PlanRobotShenZhen/SmartFOC-for-servo-motor/DOC/PLAN-SM60400D-BOM_20241017_V2.xls

Sheet: PLAN-SM60400D BOM清单
PLAN-SM60400D
序号 | 机械分类 | 层级 |  | 物料名称 | 物料编码 | 描述/规格型号 | 图示 | 材质 | 表面处理 | 数量 | 单位 | 物料类别 | 价格 | 总价 | 采购链接 | 备注 | 联系人 | 备注2
1 | 成品 | 1 |  | IPLAN-SM60400D | / | 成品，一体化伺服电机，IPLAN-SM60400D，Φ60*133.7 |  | / | / | 1 | 件 | 成品 | 63.99 |  |  |  |  | 20241017V2.0
2 |  |  | 2 | 400W电机主体 | / | 电机类，一体化伺服电机，400W，深圳丹青 |  | / | / | 1 | 件 | 半成品 | 0 |  |  |  | 深圳丹青 秦总
3 |  |  | 2 | 导光柱 | / | 机械其他，其他，导光柱，LDT3.0-2.5 |  | / | / | 1 | 件 | 半成品 | 0.21 |  | https://item.taobao.com/item.htm?_u=l20fbr48daa252&id=743519807618&skuId=5299771639683
4 |  |  | 2 | 400W后罩盖 | / | 机加件，一体化伺服电机，IPLAN-SM6040D，杭州雪尔 |  | 压铸铝 | / | 1 | 件 | 半成品 | 0 |  |  | / | 杭州雪尔 | 有18个样品，需寄出到杨金燕处二次加工
5 |  |  | 2 | 60驱动板 | / | PCBA,一体化伺服电机，60驱动板，带电源线和输出口 |  | / | / | 2 | 件 | / | 0 |  |  | 自制
6 |  |  | 2 | 导热硅胶片 | / | 机械其它，其它，60导热硅胶片，400mmx200mmx1.0mm，蓝色 |  | T=1， | / | 1 | 件 | / | 12 |  | https://item.taobao.com/item.htm?_u=h20fbr48dad315&id=642766611041&skuId=4896768733055 | 买一大片回来割 | 13825559441 | 买一块400x200x1.0mm厚
7 |  |  | 2 | 导热铝板 | / | 机械其他，其他，500mmx500mmx2.0mm，1060型材板 |  | 铝型材，T=2.0 | / | 1 | 件 | / | 50 |  | https://item.taobao.com/item.htm?id=750950364979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 | 50 |  | 买一件，直接发给杨金燕处加工
8 |  |  | 2 | 压线板 | / | 塑胶件，其他，压线板， |  | 12.9级 | / | 1 | 个 | / | 1 |  |  | 步进电机压线板，购买现成。左侧压板带硅胶垫0.81套；右侧一个压板0.5元/个 | 张总 13806120727 | 各买20个，需要顺丰到付
9 |  |  | 2 | 内六角圆柱头 M3*30 | / | 机械其他，其他，内六角圆柱头， M3*30，12.9级 |  | 12.9级 | / | 4 | 个 | / | 0.5 |  | https://detail.tmall.com/item.htm?id=22060492907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 | 电机主体与后盖固定 |  | 买2包,共计100个
10 |  |  | 2 | 内六角圆柱头 M2.5*6 | / | 机械其他，其他，内六角圆柱头， M2.5*6，12.9级 |  | 12.9级 | / | 3 | 个 | / | 0.1 |  | https://detail.tmall.com/item.htm?id=22060492907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 | 驱动板与电机主体固定 |  | 买1包/100个
11 |  |  | 2 | 内六角圆柱头 M2.5*10 |  | 机械其他，其他，内六角圆柱头， M2.5*10，12.9级 |  | 12.9级 |  | 4 | 个 |  | 0.05 |  | https://detail.tmall.com/item.htm?id=22060492907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 | 压线板与后罩盖固定 |  | 买1包/100个
12 |  |  | 2 | M2.5x18铜螺柱 | / | 机械其他，其他，M2.5x18铜螺柱 |  |  | / | 3 | 个 | / | 0.13 |  | https://detail.tmall.com/item.htm?id=541776094503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 | 后盖与散热器固定 |  | 买12包

Sheet: PLAN-SM60400D BOM清单加散热片
PLAN-SM60400D
序号 | 机械分类 | 层级 |  | 物料名称 | 物料编码 | 描述/规格型号 | 图示 | 材质 | 表面处理 | 数量 | 单位 | 物料类别 | 子件属性 | 价格 | 采购链接 | 备注 | 联系人 | 价格
1 | 成品 | 1 |  | IPLAN-SM60400D | / | 成品，一体化伺服电机，IPLAN-SM60400D，Φ60*133.7 |  | / | / | 1 | 件 | 成品 | 自制 | 7.99
2 |  |  | 2 | 400W电机主体 | / | 电机类，一体化伺服电机，400W，深圳丹青 |  | / | / | 1 | 件 | 半成品 | 外购 | 0 |  |  | 深圳丹青 秦总
3 |  |  | 2 | 导光柱 | / | 机械其他，其他，导光柱，LDT3.0-2.5 |  | / | / | 1 | 件 | 半成品 | 外购 | 0.21 | https://m.tb.cn/h.gj1XdSfViKA3yo0?tk=0w4k3X6rAfo CZ8908
4 |  |  | 2 | 400W后罩盖 | / | 机加件，一体化伺服电机，IPLAN-SM6040D，杭州雪尔 |  | 压铸铝 | / | 1 | 件 | 半成品 |  | 0 |  | / | 杭州雪尔
5 |  |  | 2 | 60驱动板 | / | PCBA,一体化伺服电机，60驱动板，带电源线、输出口 |  | / | / | 2 | 件 | / |  | 0 |  | 自制
6 |  |  | 2 | 导热硅胶片 | / | 机械其它，其它，60导热硅胶片，蓝色 |  | T=1， | / | 2 | 件 | / |  | 0 |  | 买一大片回来割 | 13825559441
7 |  |  | 2 | 导热铝板 | / | 机械其他，其他，1060型材板 |  | 铝型材，T=2.5 | / | 1 | 件 | / |  | 0 | https://m.tb.cn/h.gkkbv0WhST8rvBm?tk=iwaQ3Wp0bP1 HU0025 | 打样100个200元
8 |  |  | 2 | 散热器 | / | 机械其他，其他，散热器，40x40x40mm |  | / | / | 1 | 件 | / |  | 6 | https://m.tb.cn/h.g8ySgl2Jiuj8HjG?tk=jsmI3coeYln MF1643 | 购买后，老杨处帮忙打孔
9 |  |  | 2 | 压线板 | / | 塑胶件，其他，压线板， |  | 12.9级 | / | 1 | 个 | / |  | 1 |  | 步进电机压线板 | 张总 13806120727
10 |  |  | 2 | 60伺服后罩密封垫 | / | 硅胶件，其他，60伺服后罩密封垫 |  | 硅胶 | / | 1 | 个 | / |  | 0 |  | 买一大片回来割；散热片与后罩盖之间
11 |  |  | 2 | 内六角圆柱头 M3*35 | / | 机械其他，其他，内六角圆柱头， M3*35，12.9级 |  | 12.9级 | / | 4 | 个 | / | 外购 | 0.5 |  | 电机主体与后盖固定
12 |  |  | 2 | 十字螺丝 M2.5*6 | / | 机械其他，其他，十字螺钉，M2.5*6，12.9级 |  | 12.9级 | / | 3 | 个 | / | 外购 | 0.1 |  | 驱动板与电机主体固定
13 |  |  | 2 | 内六角圆柱头 M2.5*10 |  | 机械其他，其他，内六角圆柱头， M2.5*10，12.9级 |  | 12.9级 |  | 4 | 个 |  | 外购 | 0.05 |  | 压线板与后罩盖固定
14 |  |  | 2 | 十字槽沉头螺钉 M3*6 | / | 机械其他，其他，十字槽沉头螺钉，M3*6，12.9级 |  | 12.9级 | / | 4 | 个 | / | 外购 | 0.13 |  | 后盖与散热器固定
