PlanRobotShenZhen/SmartFOC-for-servo-motor/DOC/PLANRobot_Servo_48V_V1_2_SCH.pdf

# DESCRIPTION

# VERSIONS RECORD

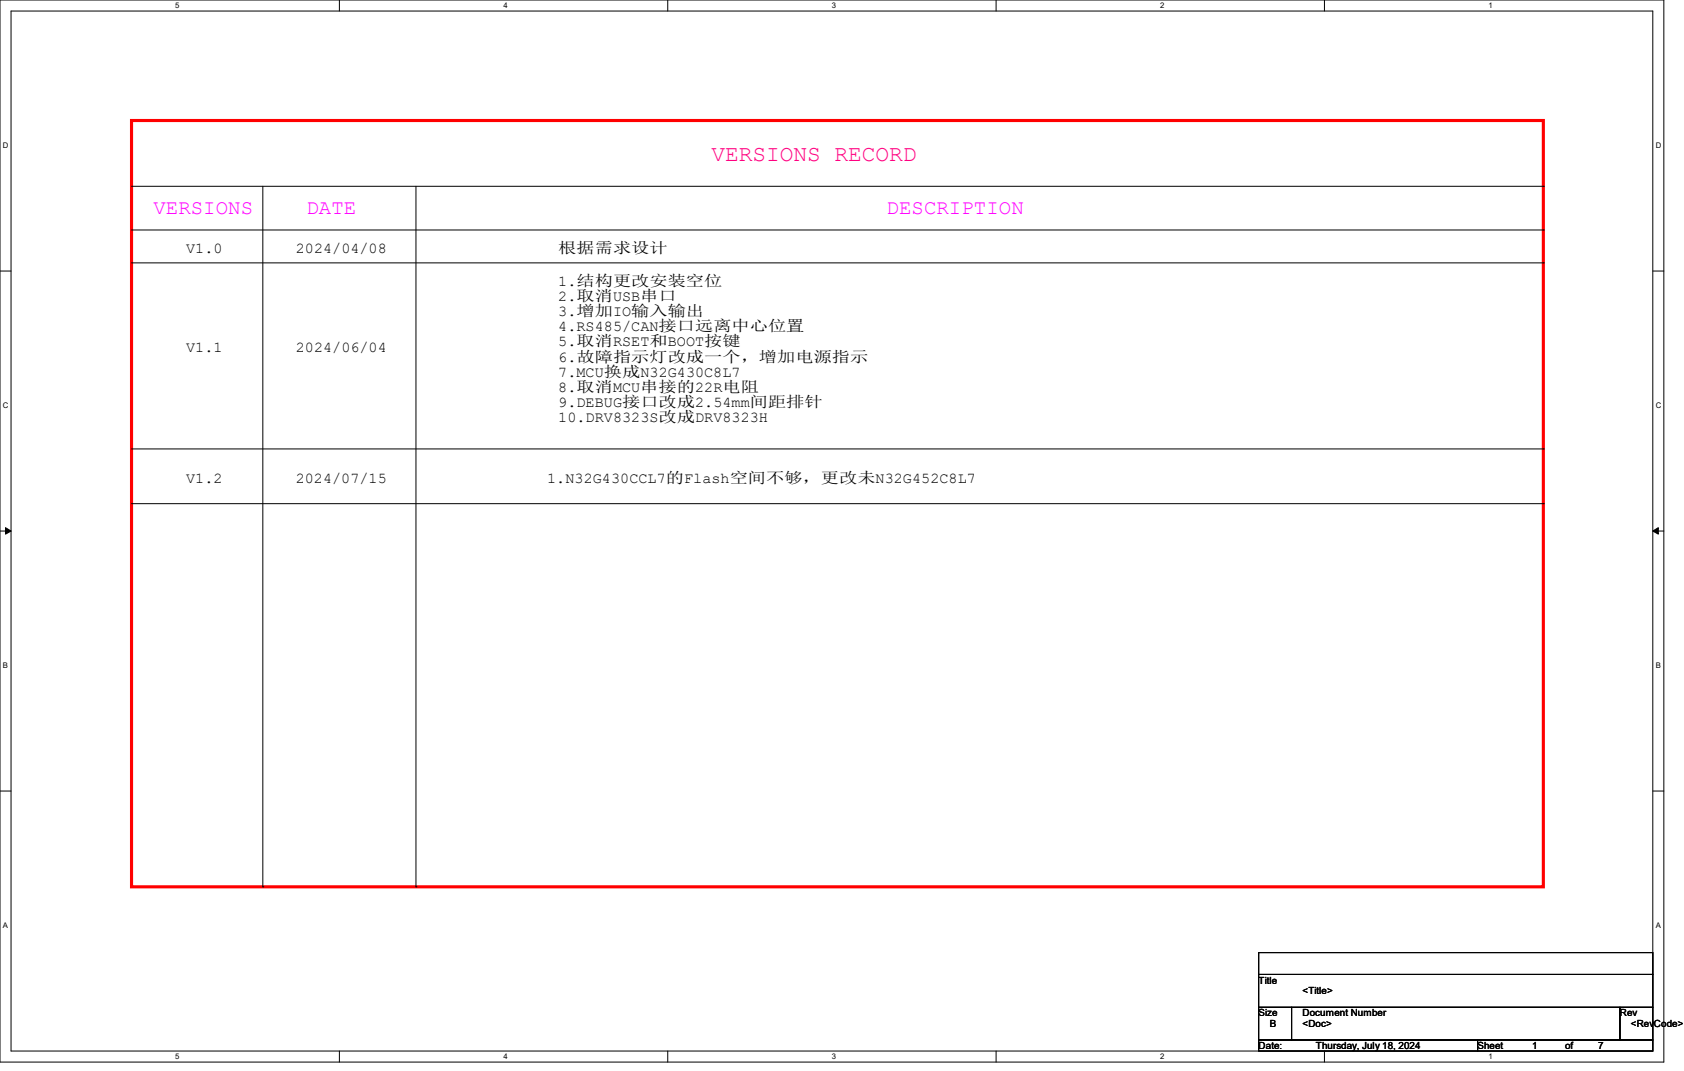
[picture p24: page 1]
VERSIONS; 根据需求设计; DATE; 1.结构更改安装空位 2.取消USB串口 3.增加IO输入输出 4.RS485/CAN接口远离中心位置 5.取消RSET和BOOT按键 6.故障指示灯改成一个，增加电源指示 7.MCU换成N32G430C8L7 8.取消MCU串接的22R电阻 9.DEBUG接口改成2.54mm间距排针 10.DRV8323S改成DRV8323H; 1.N32G430CCL7的Flash空间不够，更改未N32G452C8L7; Title Size; Document Number; Rev Date:; Sheet; of <Doc>; <RevCode>; <Title> B; Thursday, July 18, 2024; 7 Title Size

# BAT

(36-54.6V)

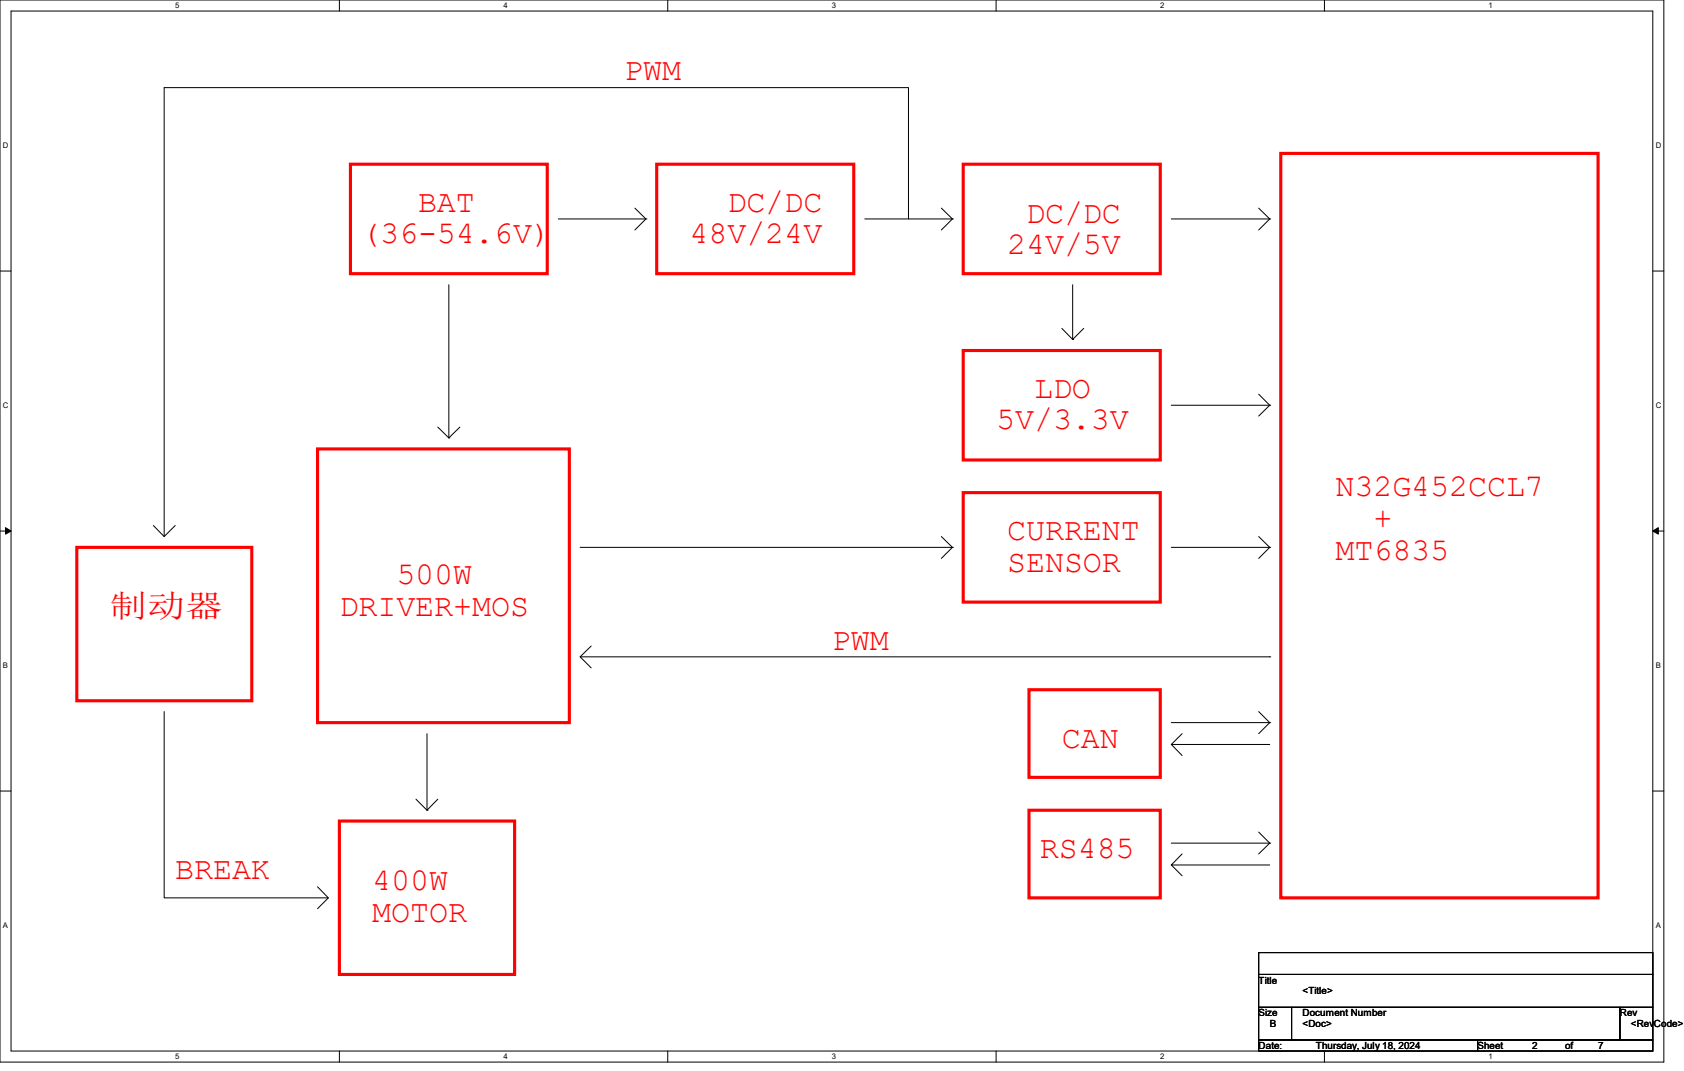
[picture p25: page 2]
LDO 5V/3.3V; N32G452CCL7 + MT6835; 500W DRIVER+MOS; 400W MOTOR; CURRENT SENSOR; PWM; BREAK; CAN; 制动器; Title Size; Document Number; Rev Date:; Sheet; of <Doc>; <RevCode>; <Title> B; Thursday, July 18, 2024; 7 Title Size

# DC/DC ->24V

## Rdown

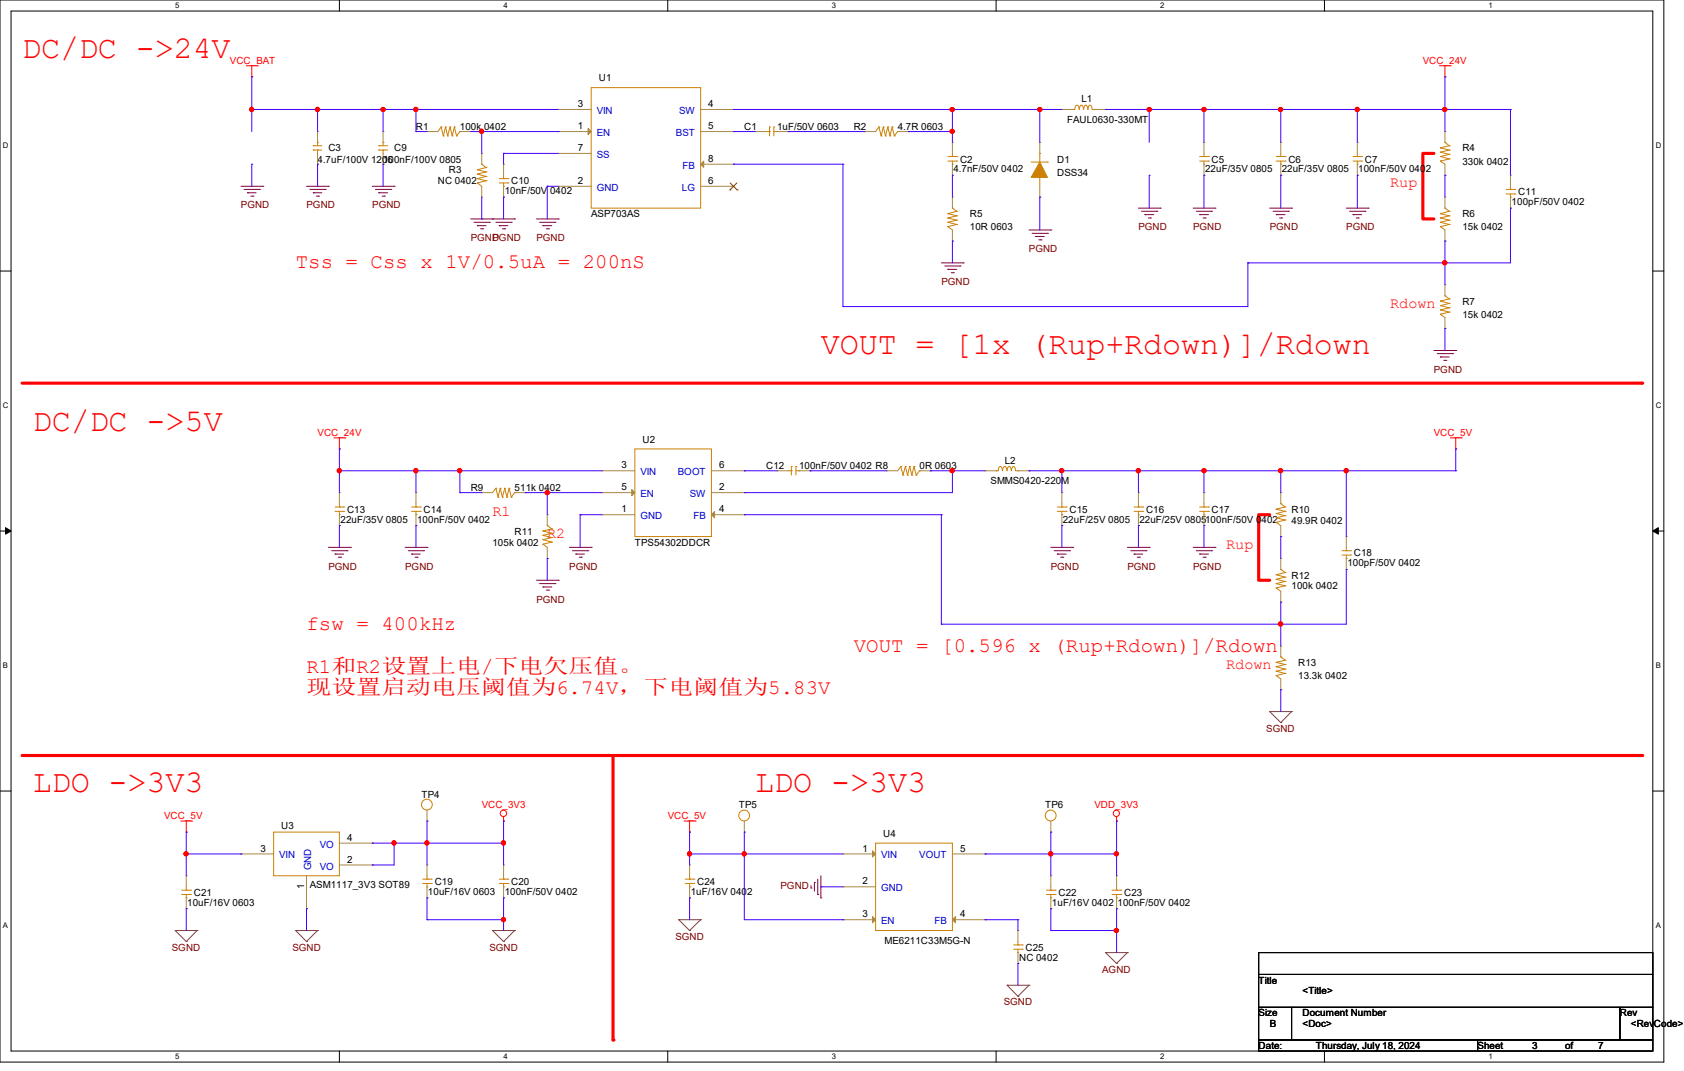
[picture p26: page 3]

VOUT = [1x (Rup+Rdown)]/Rdown

VOUT = [0.596 x (Rup+Rdown)]/Rdown

# 电机驱动

# 4.7nF/50V 0402 C38

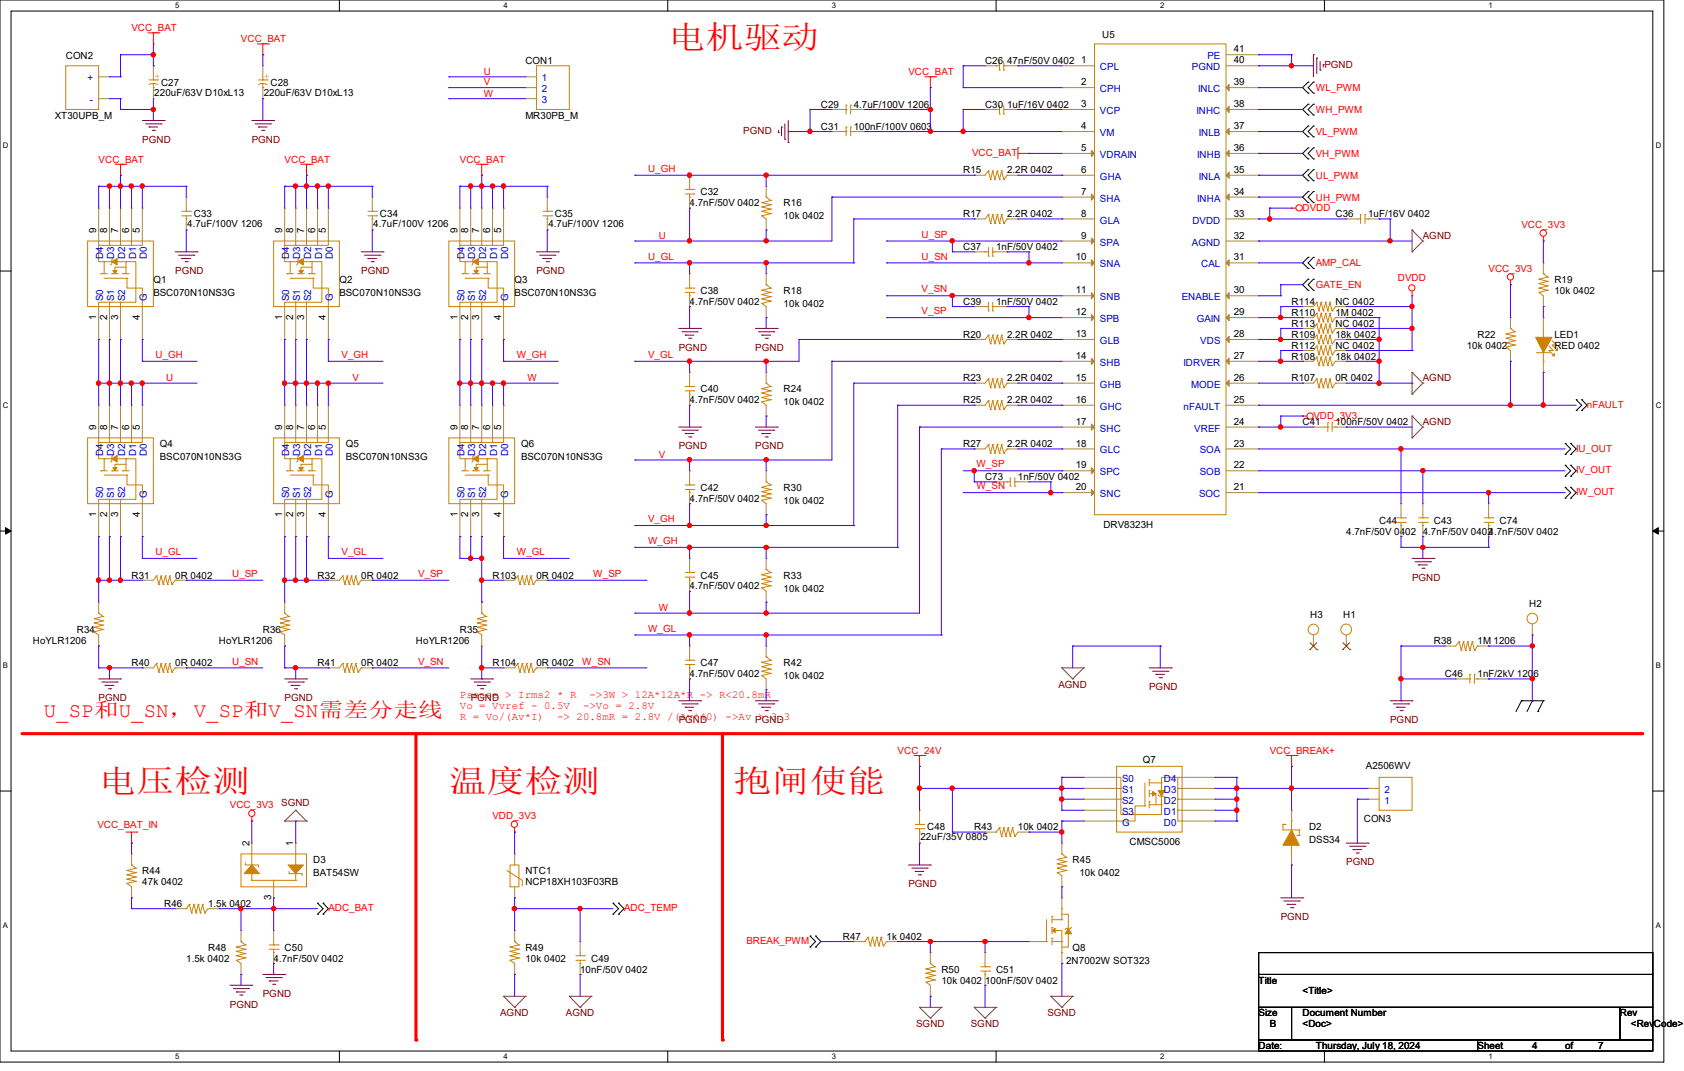
[picture p27: page 4]

R = Vo/(Av*I) -> 20.8mR = 2.8V /(Av*40) ->Av > 3.3 PGND

# DEBUG

# VCC_3V3 SGND

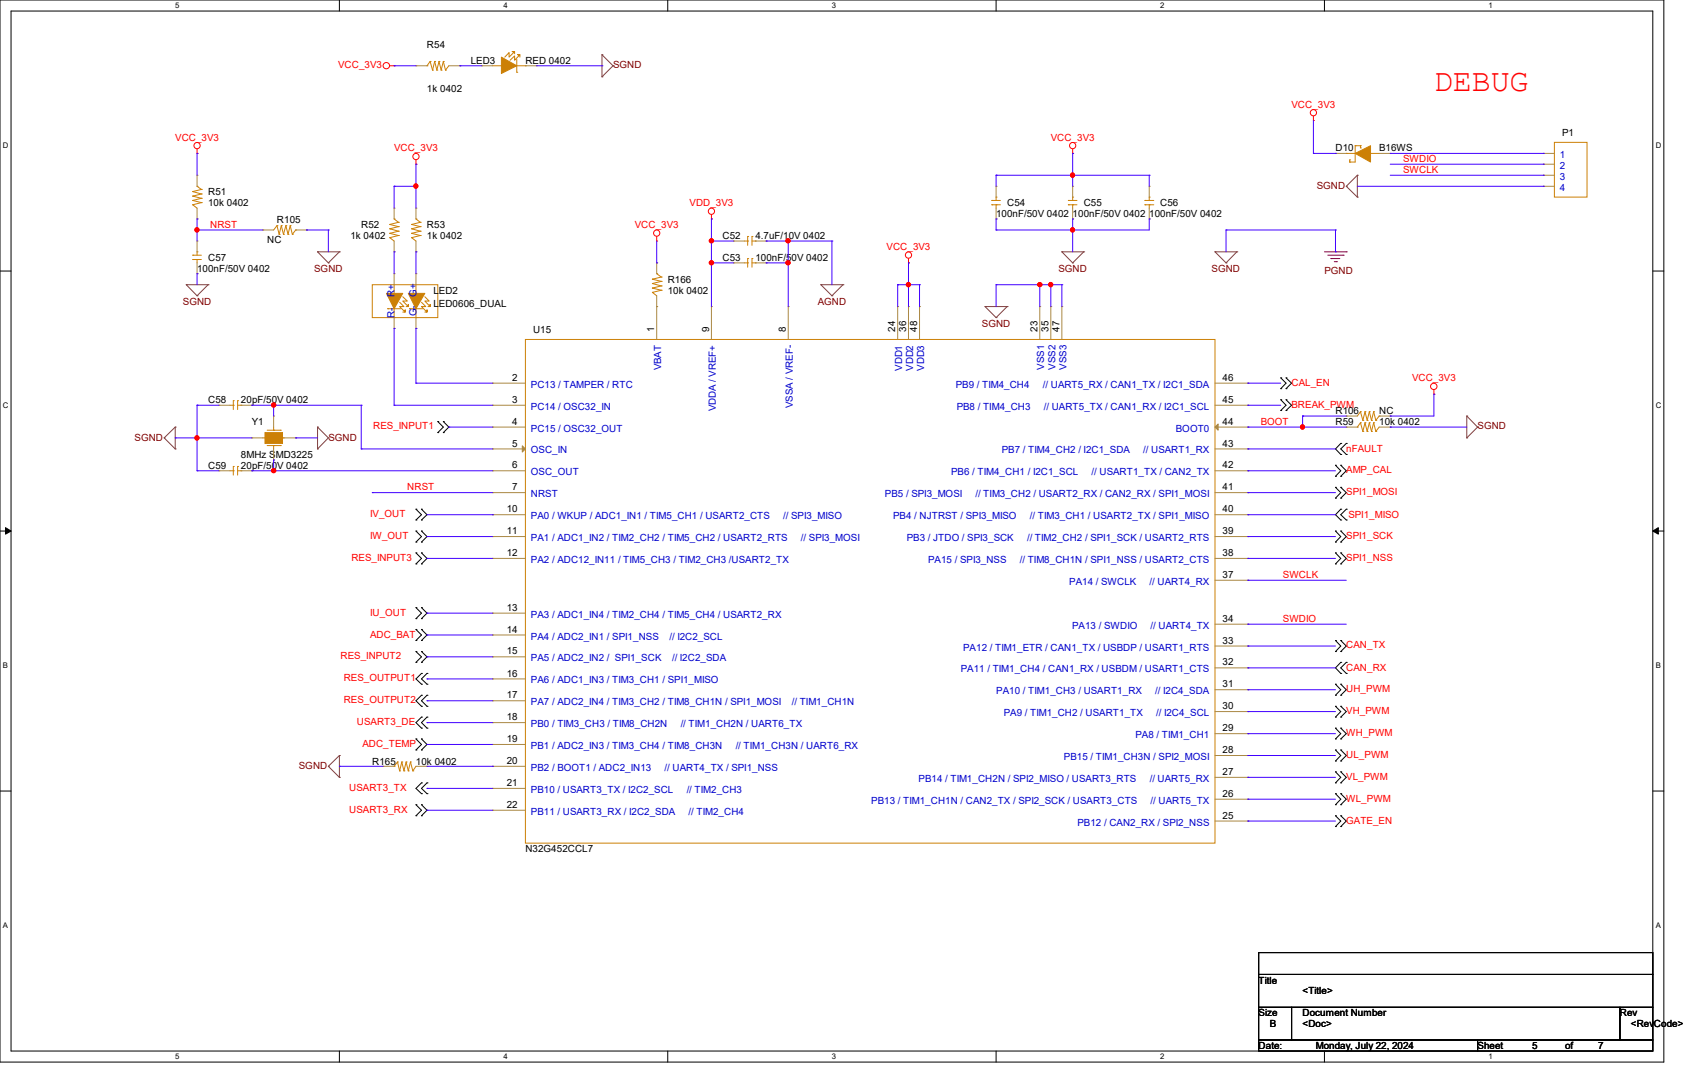
[picture p28: page 5]

# CAN通讯

# 6 A¹ A¹ A² A² D5 PESD1CAN

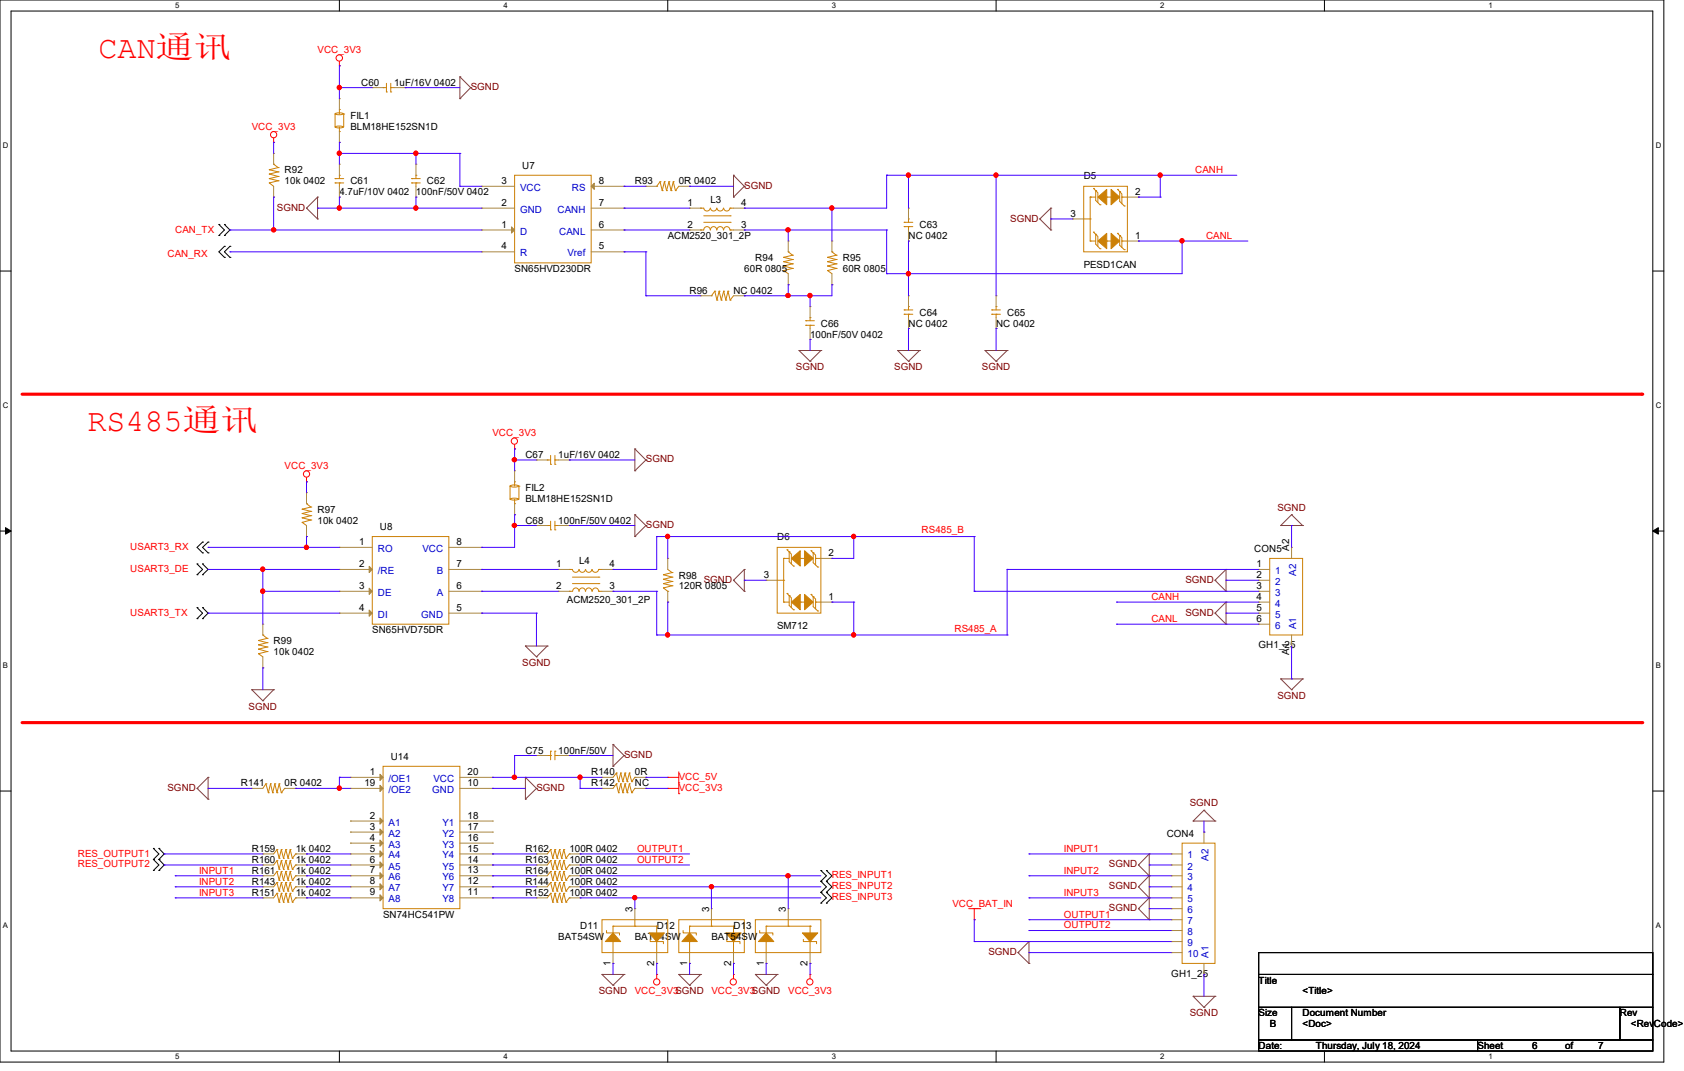
[picture p29: page 6]

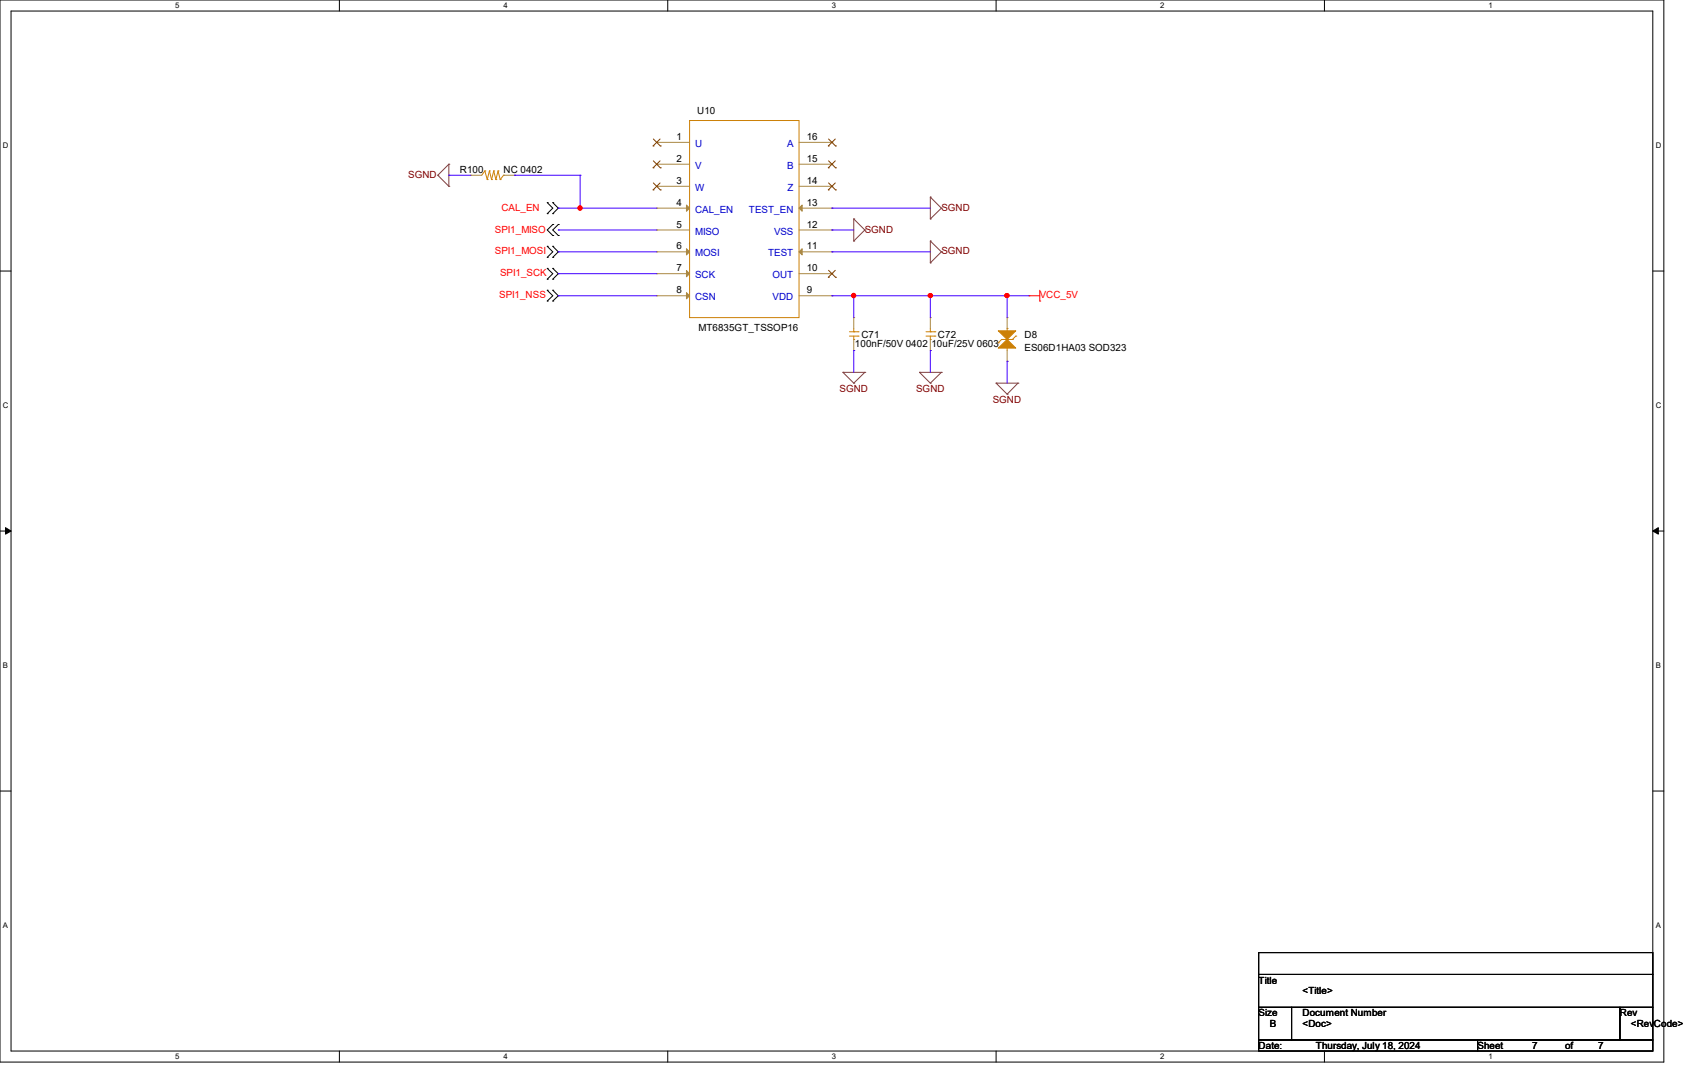
[picture p30: page 7]
VCC_5V; SGND; CAL_EN; SPI1_NSS; SPI1_SCK; SPI1_MOSI; SPI1_MISO; Title Size; Document Number; Rev Date:; Sheet; of <Doc>; <RevCode>; <Title> B; Thursday, July 18, 2024; 7 Title Size; U10 MT6835GT_TSSOP16 U; CAL_EN 4; MISO 5; MOSI 6; SCK 7; CSN 8; VDD; 9 OUT; 10 TEST; 11 VSS; 12 TEST_EN; 16 D8 ES06D1HA03 SOD323 C71
