PlanRobotShenZhen/SmartFOC-for-servo-motor/SRC/Filter.c

#include "ExternGlobals.h"
short Ids_filter(short input);
short Ids_filter2(short input);
short Ids_filter3(short input);
short  Moving_Average_Window_Filter(short input, short CHANNEL_ID,short width);
short  Moving_Average_Window_Filter_4096(short input, short CHANNEL_ID,short width);
// ========================================================================
// 函数名称：Moving_Average_Window_Filter()
// 输入参数：input
// 输出参数：result
// 扇    入：无
// 扇    出：无
// 函数描述：这是均值滤波算法，将采集到的值，求取其平均值
// ========================================================================


//每个通道只能滤波一种数据，a相电流使用通道一后，b相电流就不得使用通道一，使用时请注意不要重复使用
//滤波器长度width为0-127，ID为0-7

short  Moving_Average_Window_Filter(short input, short CHANNEL_ID,short width)
{
    static int   sum[8] = {0};
    static short buffer[8][128];
    static short point_a1[8] = {0};
    static short flag1[8] = {0};
    short reslut[8] = {0};
    short temp = buffer[CHANNEL_ID][point_a1[CHANNEL_ID]];
    sum[CHANNEL_ID] = sum[CHANNEL_ID] + input;
    buffer[CHANNEL_ID][point_a1[CHANNEL_ID]] = input;
    point_a1[CHANNEL_ID]++;

    if(flag1[CHANNEL_ID] == 0)
    {
        reslut[CHANNEL_ID] = (short)(sum[CHANNEL_ID] / point_a1[CHANNEL_ID]);//未满128个采样点
        if(point_a1[CHANNEL_ID] >= width)          
        {
            flag1[CHANNEL_ID] = 1;
            point_a1[CHANNEL_ID] = 0;
        }
    }
    else  //满128个采样点
    {
        sum[CHANNEL_ID] = sum[CHANNEL_ID] - temp;
        reslut[CHANNEL_ID] = (short)(sum[CHANNEL_ID] / width);

        if(point_a1[CHANNEL_ID] >= width)
            point_a1[CHANNEL_ID] = 0;
    }

    return reslut[CHANNEL_ID];
}


short  Moving_Average_Window_Filter_4096(short input, short CHANNEL_ID,short width)
{
    static int   sum[4] = {0};
    static short buffer[4][4096];
    static short point_a1[4] = {0};
    static short flag1[4] = {0};
    short reslut[4] = {0};
    short temp = buffer[CHANNEL_ID][point_a1[CHANNEL_ID]];
    sum[CHANNEL_ID] = sum[CHANNEL_ID] + input;
    buffer[CHANNEL_ID][point_a1[CHANNEL_ID]] = input;
    point_a1[CHANNEL_ID]++;

    if(flag1[CHANNEL_ID] == 0)
    {
        reslut[CHANNEL_ID] = (short)(sum[CHANNEL_ID] / point_a1[CHANNEL_ID]);//未满128个采样点
        if(point_a1[CHANNEL_ID] >= width)          
        {
            flag1[CHANNEL_ID] = 1;
            point_a1[CHANNEL_ID] = 0;
        }
    }
    else  //满128个采样点
    {
        sum[CHANNEL_ID] = sum[CHANNEL_ID] - temp;
        reslut[CHANNEL_ID] = (short)(sum[CHANNEL_ID] / width);

        if(point_a1[CHANNEL_ID] >= width)
            point_a1[CHANNEL_ID] = 0;
    }

    return reslut[CHANNEL_ID];
}






short Ids_filter(short input)
{
    static int   sum12 = 0;
    static short buffer1[4096];
    static short point_a1 = 0;
    static short flag1 = 0;
    short reslut = 0;
    short temp = buffer1[point_a1];
    sum12 = sum12 + input;
    buffer1[point_a1] = input;
    point_a1++;

    if(flag1 == 0)
    {
        reslut = (short)(sum12 / point_a1);
        if(point_a1 >= 128)
        {
            flag1 = 1;
            point_a1 = 0;
        }
    }
    else
    {
        sum12 = sum12 - temp;
        reslut = (short)(sum12 / 128);

        if(point_a1 >= 128)
            point_a1 = 0;
    }

    return reslut;
}
short Ids_filter2(short input)
{
    static int   sum12 = 0;
    static short buffer1[128];
    static short point_a1 = 0;
    static short flag1 = 0;
    short reslut = 0;
    short temp = buffer1[point_a1];
    sum12 = sum12 + input;
    buffer1[point_a1] = input;
    point_a1++;

    if(flag1 == 0)
    {
        reslut = (short)(sum12 / point_a1);
        if(point_a1 >= 128)
        {
            flag1 = 1;
            point_a1 = 0;
        }
    }
    else
    {
        sum12 = sum12 - temp;
        reslut = (short)(sum12 / 128);
        if(point_a1 >= 128)
            point_a1 = 0;
    }

    return reslut;
}
short Ids_filter3(short input)
{
    static int   sum12 = 0;
    static short buffer1[128];
    static short point_a1 = 0;
    static short flag1 = 0;
    short reslut = 0;
    short temp = buffer1[point_a1];
    sum12 = sum12 + input;
    buffer1[point_a1] = input;
    point_a1++;

    if(flag1 == 0)
    {
        reslut = (short)(sum12 / point_a1);
        if(point_a1 >= 128)
        {
            flag1 = 1;
            point_a1 = 0;
        }
    }
    else
    {
        sum12 = sum12 - temp;
        reslut = (short)(sum12 / 128);
        if(point_a1 >= 128)
            point_a1 = 0;
    }

    return reslut;
}
