PlanRobotShenZhen/SmartFOC-for-servo-motor/SRC/fir16.asm

;========================================================================
;
; File Name     : fir16.asm
; 
; Originator    : Advanced Embeeded Control (AEC)
;                 Texas Instruments Inc.
; 
; Description   : This file contain source code for 16-bit FIR Filter
;               
; Date          : 12/05/2002 (DD/MM/YYYY)
;======================================================================
; 
; Routine Name  : Generic Function      
; Routine Type  : C Callable
; 
; Description   :
; void FIR16_calc(FIR16_handle) 
;       
; This routine implements the non-recursive difference equation of an 
; all-zero filter(FIR), of order N. All the coefficients of all-zero 
; filter are assumed to be less than 1 in magnitude.
;======================================================================
;
; Difference Equation :
;
;       y(n)=H(0)*x(n)+H(1)*x(n-1)+H(2)*x(n-2)+....+H(N)*x(n-N)
;
;      where
;              y(n)=output sample of the filter at index n 
;              x(n)=input sample of the filter at index n 
;
; Transfer Function :
;                                  
;              Y(z)                -1        -2               -N+1       -N
;             ----- = h(0) + h(1) z  + h(2) z  + ... +h(N-1) z   + h(N) z    
;              X(z)
;
;     Network Diagram  : 

;     dbuffer[0]          dbuffer[1]    dbuffer[2]    dbuffer[N}
;     Input           -1  x(n-1)  -1    x(n-2)        x(n-N)
;   x(n) >------o----z---->-o----z---->-o---  - ->- - o
;               |           |           |             |
;               |           |           |             |
;               |           |           |             |
;               v H(0)      v H(1)      v H(2)        v H(N)  
;               |           |           |             |  
;               |           |           |             |        output
;               |---->-----(+)---->----(+)-- - -> -  (+)-----> y(n)    
;
;       Symbols Used :
;             H(0),H(1),H(2),...,H(N) : filter coefficients
;            x(n-1),x(n-2),...,x(n-N) : filter states
;                                x(n) : filter input 
;                                y(n) : filter output
;==============================================================================         
;  Function Input: This function accepts the handle of the below structure
;
;  typedef struct { 
;      int *coeff_ptr;          /* Pointer to Filter co-efficient array */
;      int *dbuffer_ptr;        /* Delay buffer pointer                 */ 
;	   int cbindex;				/* Circular Buffer Index				*/
;      int order;               /* Order of the filter                  */
;      int input;               /* Input data                           */
;      int output;              /* Output data                          */ 
;      void (*init)(void *)     /* Pointer to init fun                  */  
;      void (*calc)(void *);    /* Pointer to the calculation function  */
;     }FIR16_handle;    
;       
; Module definition for external referance
                .def    _FIR16_init 
                .def    _FIR16_calc

				.sect	".text"

				.sect "ramfuncs"
_FIR16_init:	
            MOV     *+XAR4[6],#0    ; XAR4->ouput, input=0
            MOV     *+XAR4[7],#0    ; output=0

            MOVL    XAR6,*+XAR4[2]  ; XAR6=dbuffer_ptr            
			MOV 	AL,*+XAR4[5]	; AL=order
			MOV		AH,AL			; AH=order
			TBIT 	AL,#0				
			ADDB 	AL,#1			; AL=order+1		
			MOV 	AL,AH,TC		; AL=order, if odd

            MOV		AH,AL
            SUBB	AH,#1
            MOV		*+XAR4[4],AH	; cbindex=order, even
            						; 		 =order-1, odd
            
            RPT     AL
            || MOV      *XAR6++,#0
            
            LRETR




ConstTable: 
PosSatVal:    .long    0x00FFFFFF   ; Corresponds to >> 6 
NegSatVal:    .long    0xFF000000   ; Corresponds to >> 6 


_FIR16_calc:    
            PUSH    XAR1            ; Context Save
            
            SETC    SXM,OVM         ; AR4=FIR16_handle->coeff_ptr 
      		SPM   -6                ; Create guard band of >> 6

            MOVL    XAR7,*XAR4    	; XAR4->coeff_ptr, XAR7=coeff_ptr


		
			MOV ACC,*+XAR4[4]
			MOV AH,*+XAR4[5]			
			MOVL XAR1,@ACC	

			
			
			MOVL    XAR6,*+XAR4[2] 	; XAR4->coeff_ptr, XAR6=dbuffer_ptr 		 
      		MOVL  	ACC,*+XAR6[AR1]       ; ACC = -:X 
      		MOV   	AH,@AL          ; ACC = X:X 
      		MOV   	AL,*+XAR4[6]    ; ACC = X:Input  








			SETC    AMODE      	
      		MOVL  	*+XAR6[AR1%++],ACC    ; Store in data array and inc circ address 			
			CLRC    AMODE 
			
			 
			MOV  	*+XAR4[4],AR1
 

            MOV		ACC,*+XAR4[5]<<15  	; AR0=cbindex
            MOVZ	AR0,AH			; AR0=order/2
            
            ZAPA                    ; Zero the ACC, P registers and OVC counter
      		
 			RPT		AR0
			|| DMAC	ACC:P,*+XAR6[AR1%++],*XAR7++
			
			ADDL  	ACC,P       	; Add the two sums with shift 
      		
			MOVW	DP,#PosSatVal
      		MINL  	ACC,@PosSatVal 	; Saturate result 

		    MOVW 	DP,#NegSatVal
      		MAXL  	ACC,@NegSatVal 

    		MOVH  	*+XAR4[7],ACC<<7; Store saturated result (Q15) 
    		
    		SPM	  	0

            POP     XAR1 
            CLRC    OVM
            LRETR      
            

                           
