PlanRobotShenZhen/SmartFOC-for-servo-motor/SRC/SystemVar.h

#ifndef __SYSTEMVAR_H__
#define __SYSTEMVAR_H__

typedef struct
{
    short SoftwareVersion;
    short HardwareVersion;
	  short MotorVersion;
    short Version[8];
    short Administrators[10];
    short MotorVar[50];


    /****开环参数*********/
    short VF_Voltage;
    short VF_ElectricalAngle;
    short VF_Coefficient;
    short VF_Coefficient_B;
    short VF_ElectricalAngleStepMax;
    short VF_ElectricalAngleStepMin;
    short VF_ElectricalAngleStep;
    short VF_ElectricalAngleStepCount;

    /****开环参数*********/

    /****电机参数*********/
    short test_uqs;
    short test_angle;
    /****电机参数*********/

    short ModbusID;
    short ModbusBaudrate;
    short CanopenID;
    short CanopenBaudrate;

} SYSTEMVAR;

typedef SYSTEMVAR* SYSTEMVAR_handle;

/*-----------------------------------------------------------------------------
Default initalizer for the PIDREG3 object.
-----------------------------------------------------------------------------*/
#define PID_DEFAULTS { 0, \
        0, \
        0, \
        0, \
        0, \
        0, \
        0, \
        0, \
        0, \
        0, \
        0, \
        0, \
        0, \
        (void (*)(unsigned int))pid_calc }

/*------------------------------------------------------------------------------
Prototypes for the functions in PIDREG3.C
------------------------------------------------------------------------------*/
//void pid_calc(PID_handle);
#endif
