PlanRobotShenZhen/SmartFOC-for-servo-motor/SRC/UartMode.h

#ifndef __UARTMODE_H__
#define __UARTMODE_H__

typedef struct
{
    short Mode;
    short ModePass;//模式切换后，需要重置所以参数
    short ModePass2;//模式切换后，需要重置所以参数
    short CMD;
    short Speed;
    short VF_Ref;
    short State;
    short Enable;
    short DisEnable;
    short Start;
    short Stop;
    short Torque;
    short TorqueK;
    int TargetPosition;

} UARTMODE;

typedef UARTMODE* UARTMODE_handle;

/*-----------------------------------------------------------------------------
Default initalizer for the PIDREG3 object.
-----------------------------------------------------------------------------*/
#define PID_DEFAULTS { 0, \
        0, \
        0, \
        0, \
        0, \
        0, \
        0, \
        0, \
        0, \
        0, \
        0, \
        0, \
        0, \
        (void (*)(unsigned int))pid_calc }

/*------------------------------------------------------------------------------
Prototypes for the functions in PIDREG3.C
------------------------------------------------------------------------------*/
//void pid_calc(PID_handle);
#endif
